bracco64/Dry-Contact-Home-Assistant/Immagini/IMG_20250130_100835.jpg

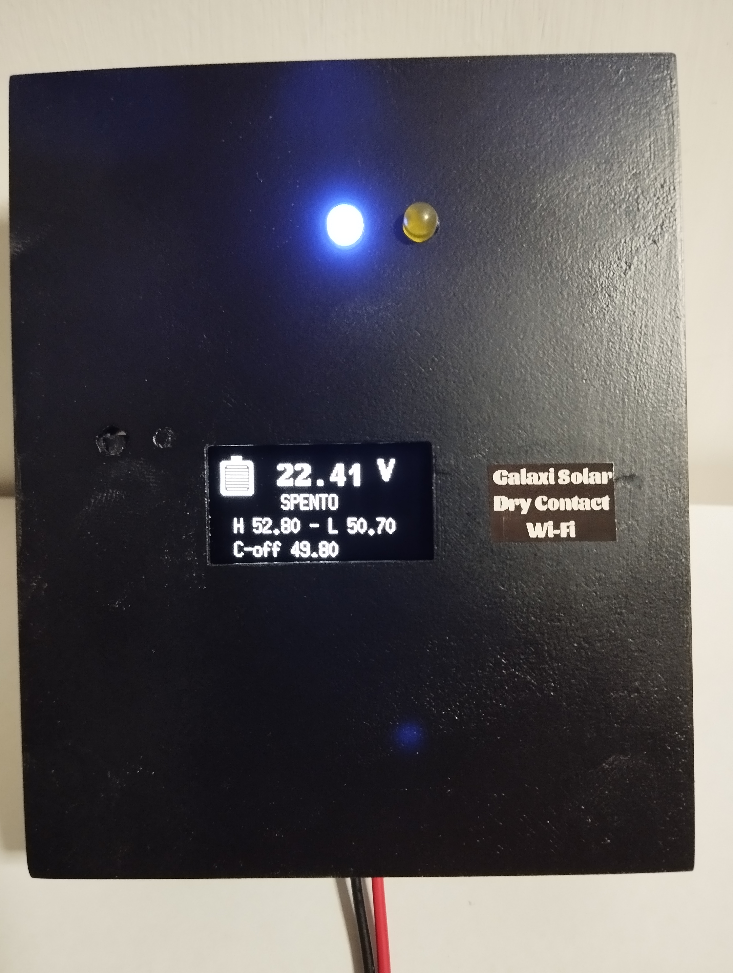
Immagini/IMG_20250130_100835.jpg
