bracco64/Dry-Contact-Home-Assistant/README.md

# Dry-Contact-Home-Assistant
progetti fai da te
**********************************
Legge la tensione della batteria ed attiva / disattiva un relè a delle soglie di tensione preimpostate. 
Il progetto si basa sul controllore ESP8266 e un convertitore A/D a 16 bit per una maggiore precisione
nella lettura rispetto all'ingresso A/D del controllore (10 bit).
Il relè utilizzato è a stato solido per ridurre al minimo l'assorbimento del circuito.
La tensione letta, lo stato del relè, le soglie impostate sono visibili sul sul display da 1.3 pollici.
I due led segnalano la connessione al WiFi (Blu) e lo stato del relè (Giallo).
Il Dry contact può essere impostato collegandosi al suo web server con qualsiasi dispositivo connesso
alla stessa rete con un comunissimo browser. Una volta impostato i dati rimarranno persistenti sul
dispositivo.

Integrazione in Home Assistant:
Installare un broker MQTT in HA (mosquito)
Il dispositivo pubblica i dati con il protocollo MQTT e dall'interfaccia di HA è possibile visualizzare
e modificare le impostazioni.

Alla prima accensione, non avendo ancora impostato una rete WiFi a cui connettersi, il dispositivo funzionerà con i parametri di default.
Premendo il tasto "CONFIG" il dispositivo entrerà in modalità configurazione come segnalato sul display. Connettersi alla wifi generata
(DryContactAP), selezionare la wifi alla quale si deve connettere, inserite i dati del server MQTT e salvare.




Al riavvio il dispositivo si connetterà alla Vs. rete Wifi e sul display apparirà l'indirizzo IP assegnato dal router.
Collegarsi con un browser e settare i parametri "Tensione Alta, Tensione Bassa, Calibrazione, Tensione CutOff"

Screenshot_2025-01-09-14-38-27-692_com android chrome 2



Funzionamento:  Il contatto del relè è normalmente aperto e quando la tensione della batteria raggiunge la Tensione Alta il Relè si attiva, quando la batteria scende e la tensione raggiunge la Tensione Bassa il relè si disattiva.
E' possibile attivare il relè manualmente da web oppure HA anche se la tensione della batteria non ha ancora raggiunto la
soglia alta (funzionamento manuale). In questo stato la soglia bassa non interviene. Quando la batteria raggiunge la soglia alta lo stato manuale viene resettato e le soglie vengono riattivate per il normale funzionamento. Se la batteria non dovesse raggiungere nello stato manuale la soglia alta, sarà la TENSIONE DI CUTOFF ad intervenire e resettare lo stato manuale e riportarlo al funzionamento automatico.

Calibrazione: Per allineare la lettura della tensione del Dry Contact rispetto alla tensione letta sul display della batteria
agire sul parametro. il valore 100 aumenta la lettura di 100 mV. sono ammessi anche valori negativi (-100).

Nel caso di problemi con la wifi del router e quindi disconnessione dalla rete il dry contact continuerà a funzionare con gli ultimi parametri impostati. Al ripristino della wifi il dispositivo si riconnetterà automaticamente.

LISTA COMPONENTI:

N.1 Wemos D1 R1 esp8266

N.1 ADS1115 I2C (Convertitore A/D 16bit)

N.1 AZ-delivery 1,3 I2C OLED DISPLAY

N.1 SSR-41FDA relè stato solido

N.1 Modulo Step-Down USB DC convertitore Buck da 9-85V a 5V

N.2 Led

N.1 Switch Reset

N.3 Resistenze 1.5K

N.1 Resistenza 100K

N.1 Resistenza 2.2K

N.1 Condensatore 0.1

******** Progetto "GALAXI SOLAR" 2025 by G.Abate ***********
