bracco64/Dry-Contact-Home-Assistant/Immagini/IMG_20250129_092707.jpg

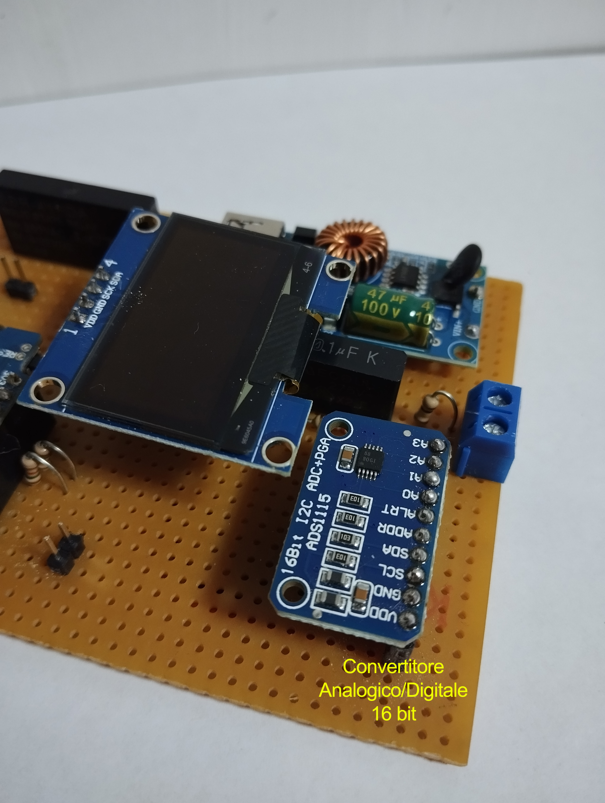
Immagini/IMG_20250129_092707.jpg
