bracco64/Dry-Contact-Home-Assistant/Schema_Elettrico.png

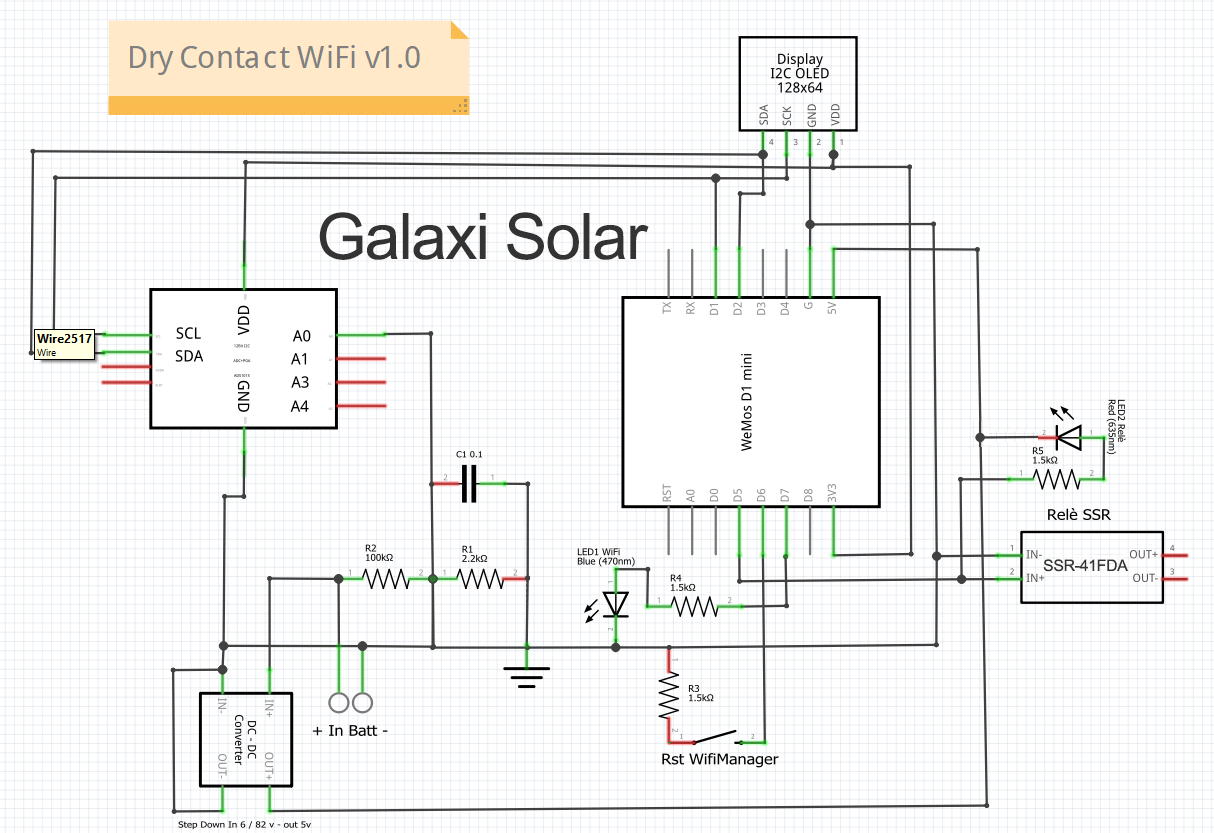
Schema_Elettrico.png
